koendv/si5351-clock-generator/hardware/3D_PCB1_2024-06-07-bottom.png

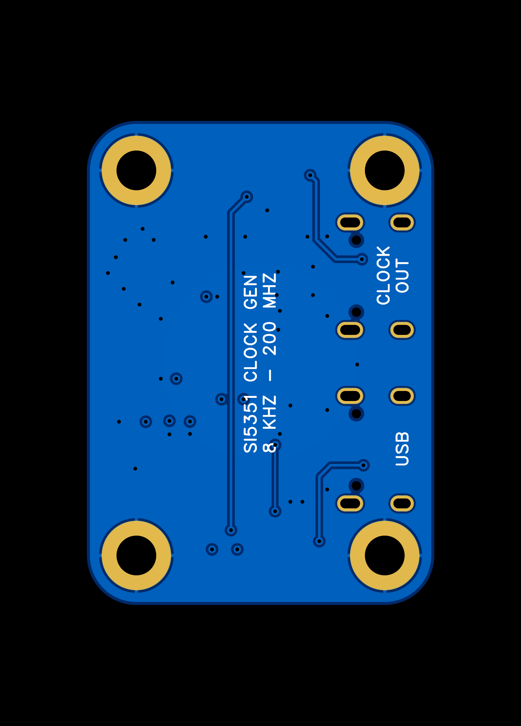
hardware/3D_PCB1_2024-06-07-bottom.png
