koendv/si5351-clock-generator/hardware/SCH_Schematic1_2024-06-06.pdf

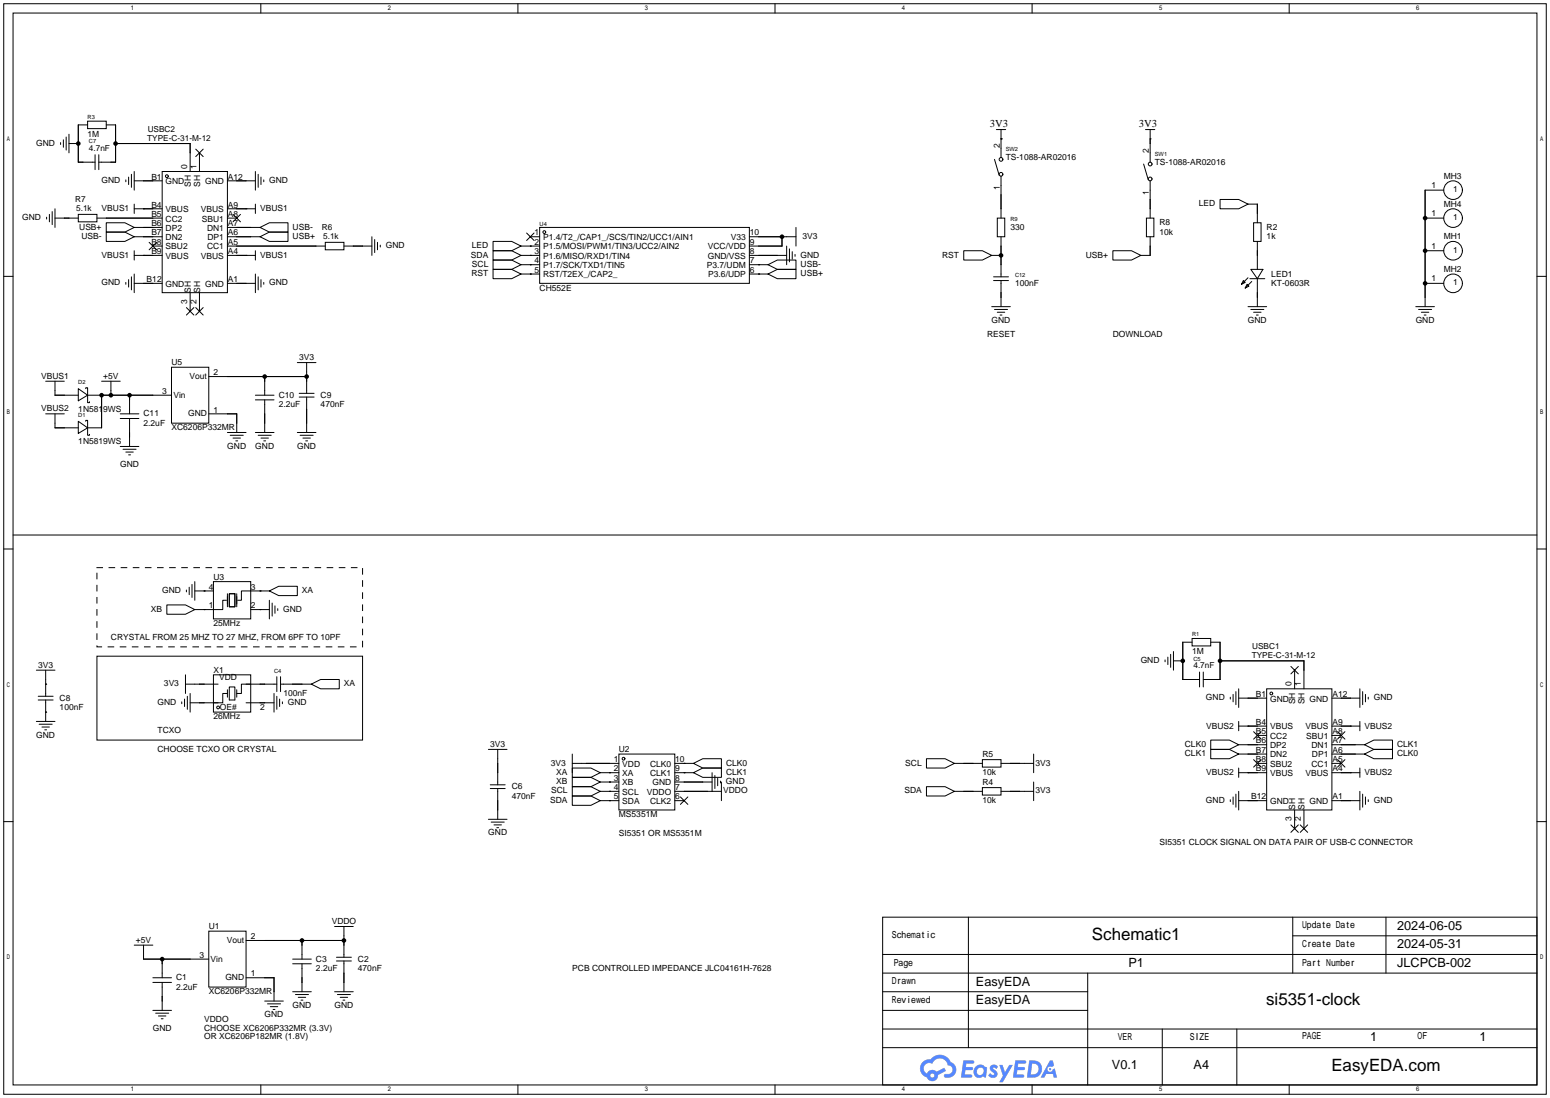
[picture p5: page 1]

CRYSTAL FROM 25 MHZ TO 27 MHZ, FROM 6PF TO 10PF

TCXO
CHOOSE TCXO OR CRYSTAL

SI5351 CLOCK SIGNAL ON DATA PAIR OF USB-C CONNECTOR
