koendv/si5351-clock-generator/hardware/PCB_PCB1_2024-06-06.pdf

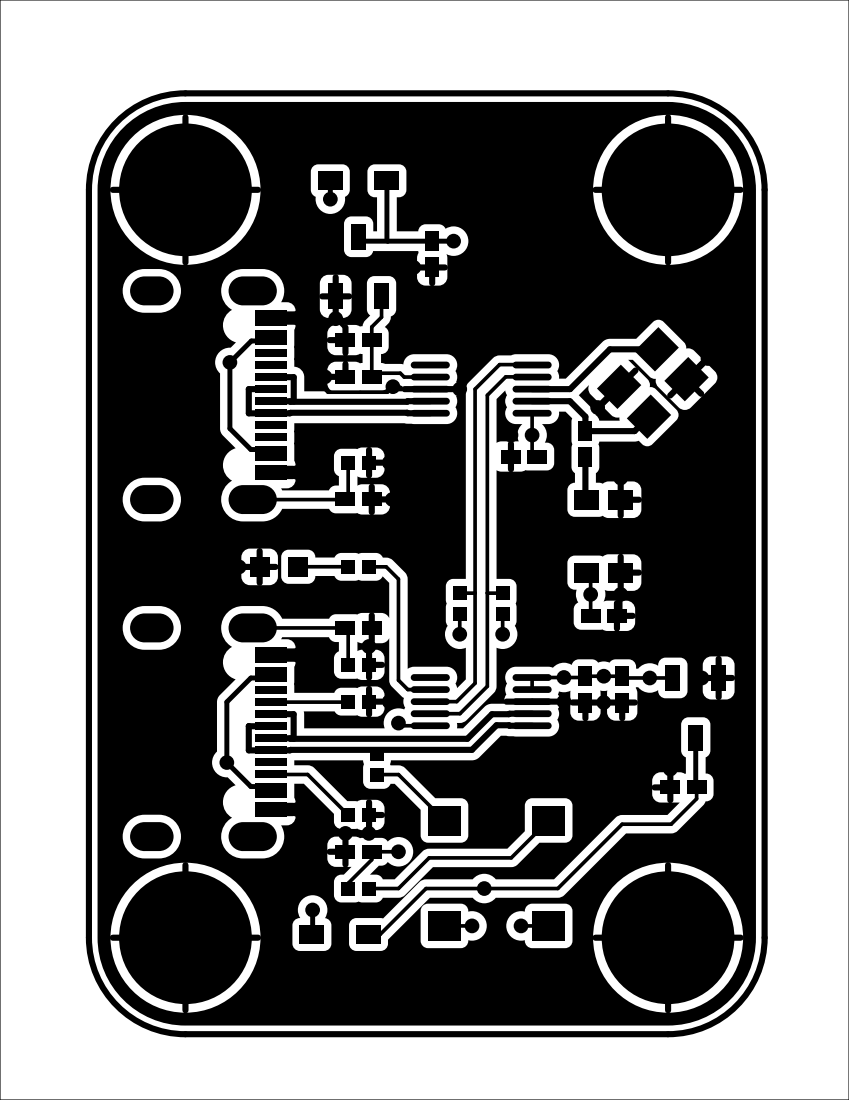
[picture p6: page 1]

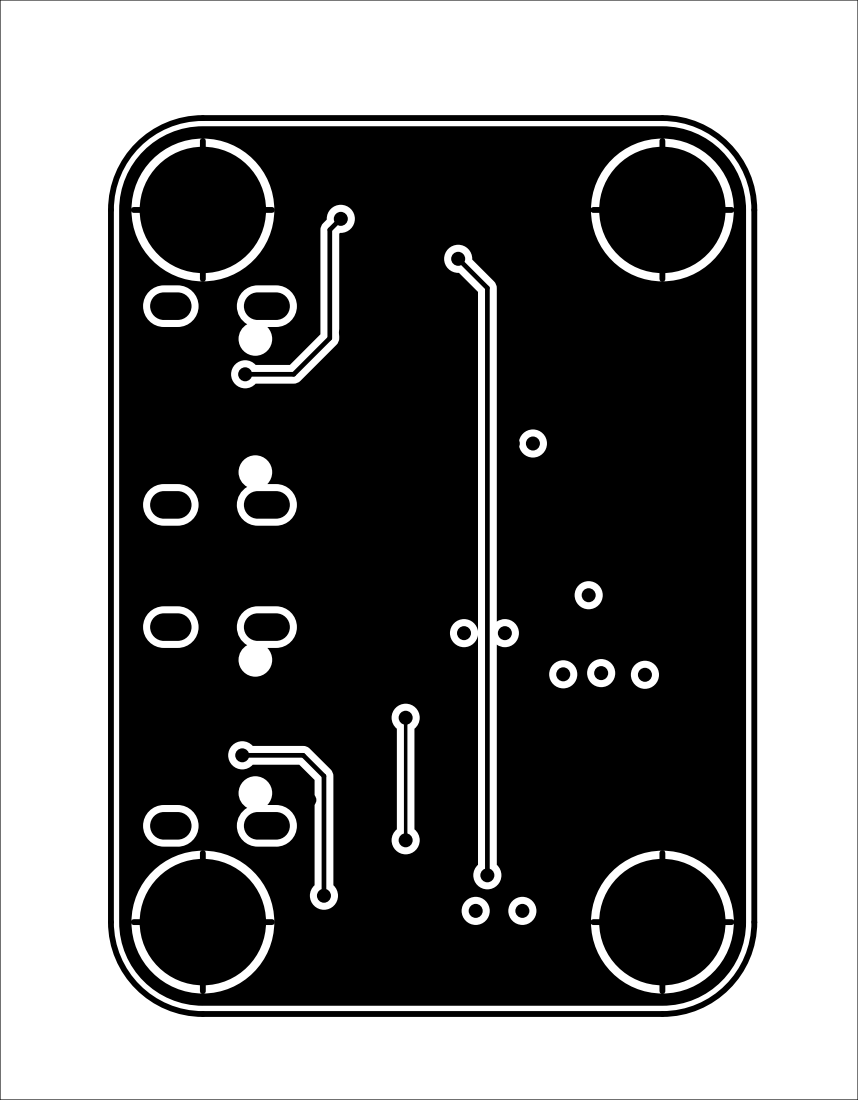
[picture p7: page 2]

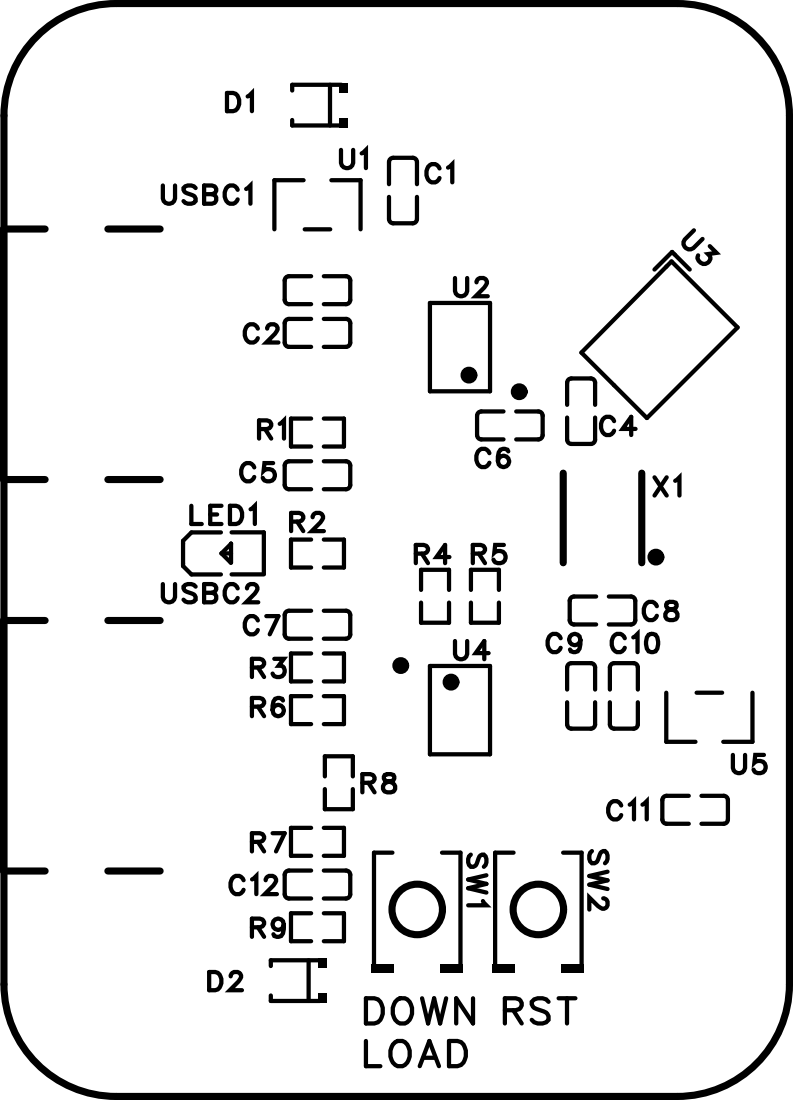
[picture p8: page 3]

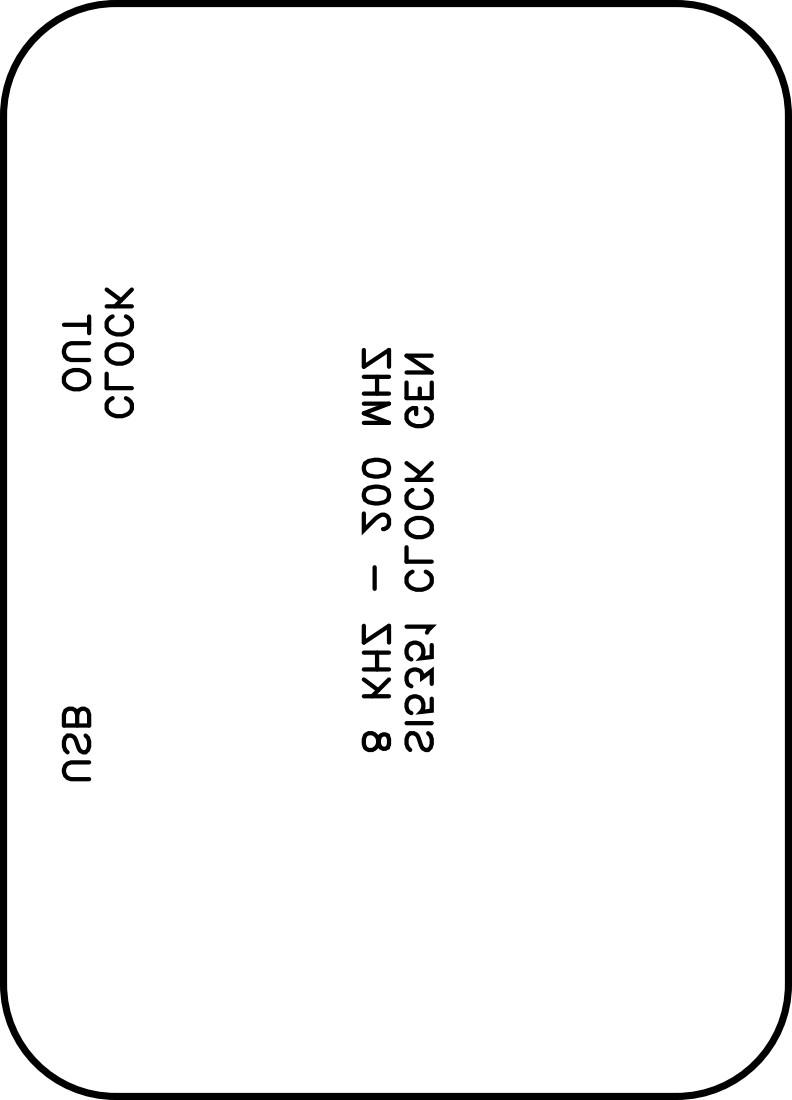
[picture p9: page 4]

SI5351 CLOCK GEN8 KHZ - 200 MHZ

CLOCK OUT USB

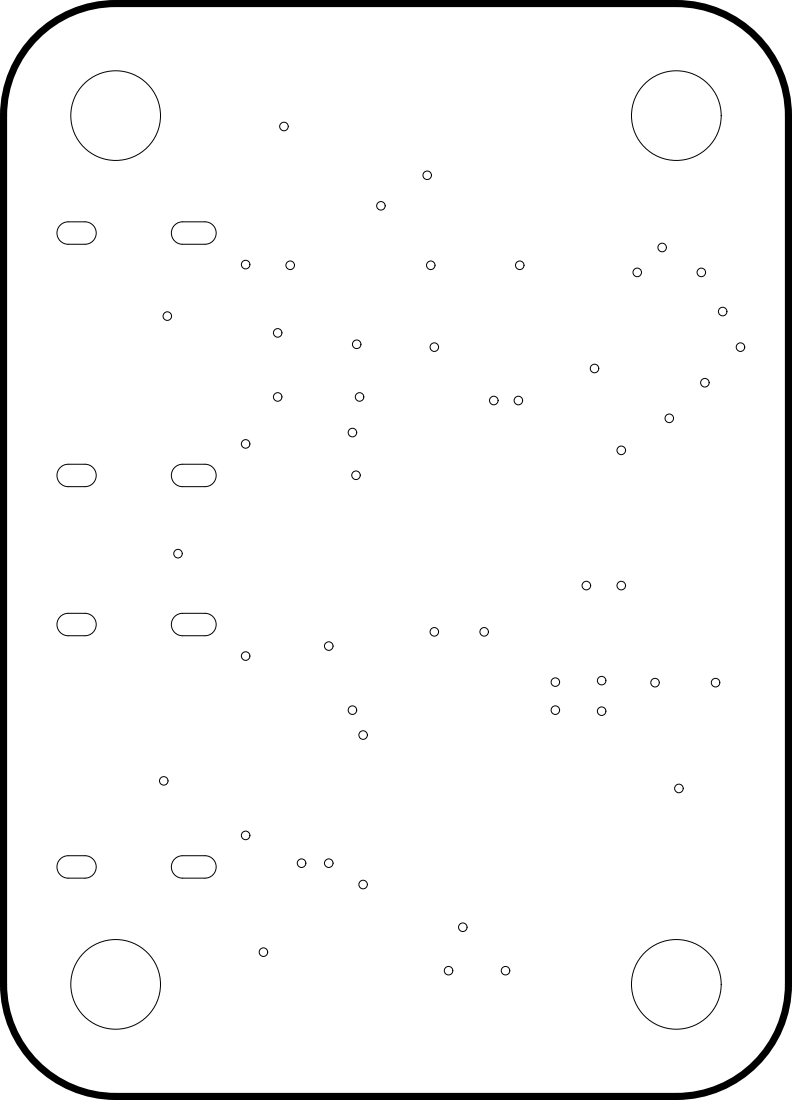
[picture p10: page 5]
