koendv/si5351-clock-generator/(list of files, drawings)

Other design files:
hardware/ProProject_si5351-clock_2024-06-27.epro
